74ls00/PinBasic/datasheet/ReadMe.md

LIN-601R cхема платы клавиатуры

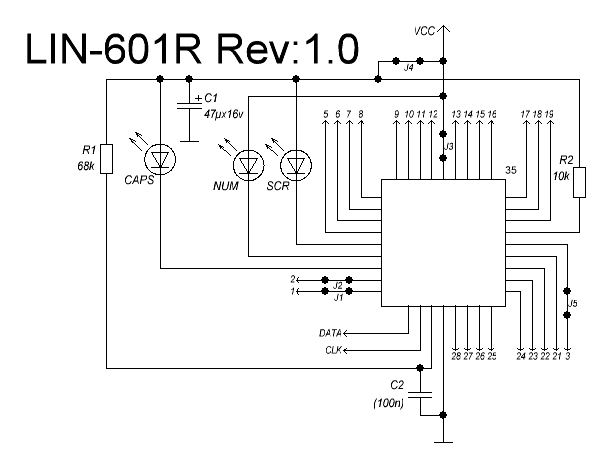
[picture p1: datasheet/LIN-601R.GIF]
