74ls00/PinBasic/todo.txt

112*61mm

порты слишком близком к кнопкам.

высота кнопок от 5-7мм.

кнопки шифт удобнее в центре.

аналоговые порты не могут быть испрользованы как выход ?
