74ls00/PinBasic/aduinobasic_sh.pdf

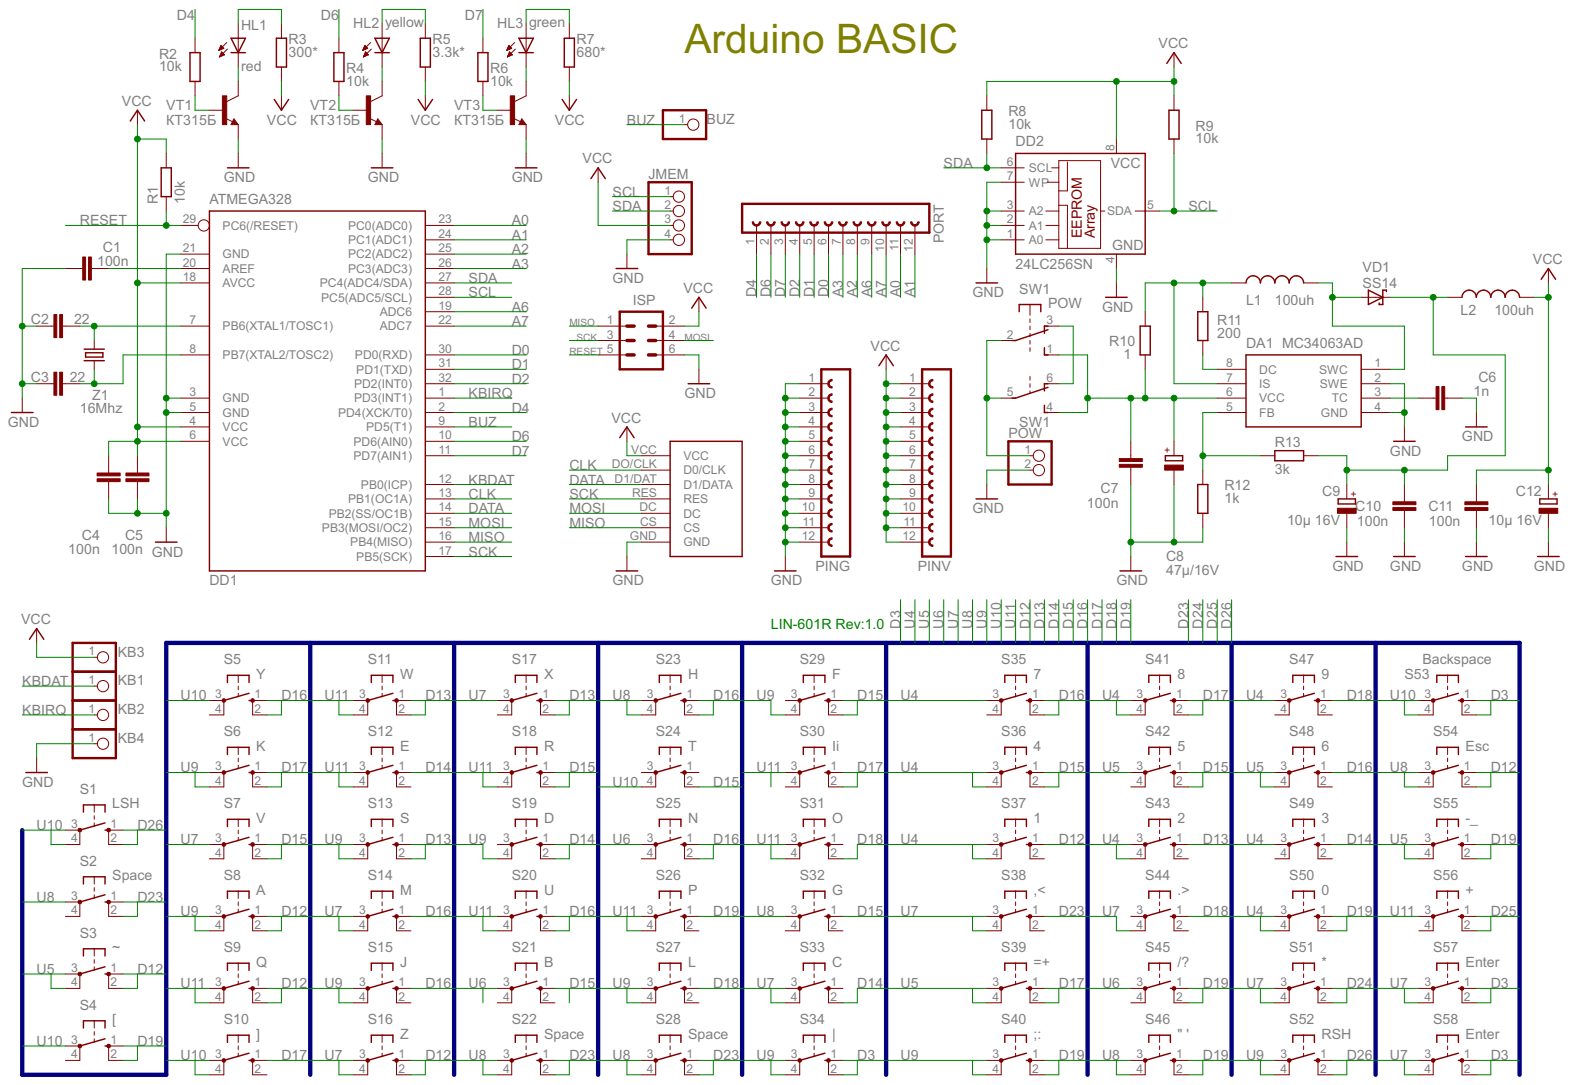
[picture p2: page 1]
