74ls00/PinBasic/(list of files, drawings)

Other design files:
datasheet/LIN-601R.spl7
keyboard.lay6
PinBASIC.lay6
TODO/ab.lay
