74ls00/PinBasic/aduinobasic.brd

## EAGLE design aduinobasic.brd (2017-09-14)

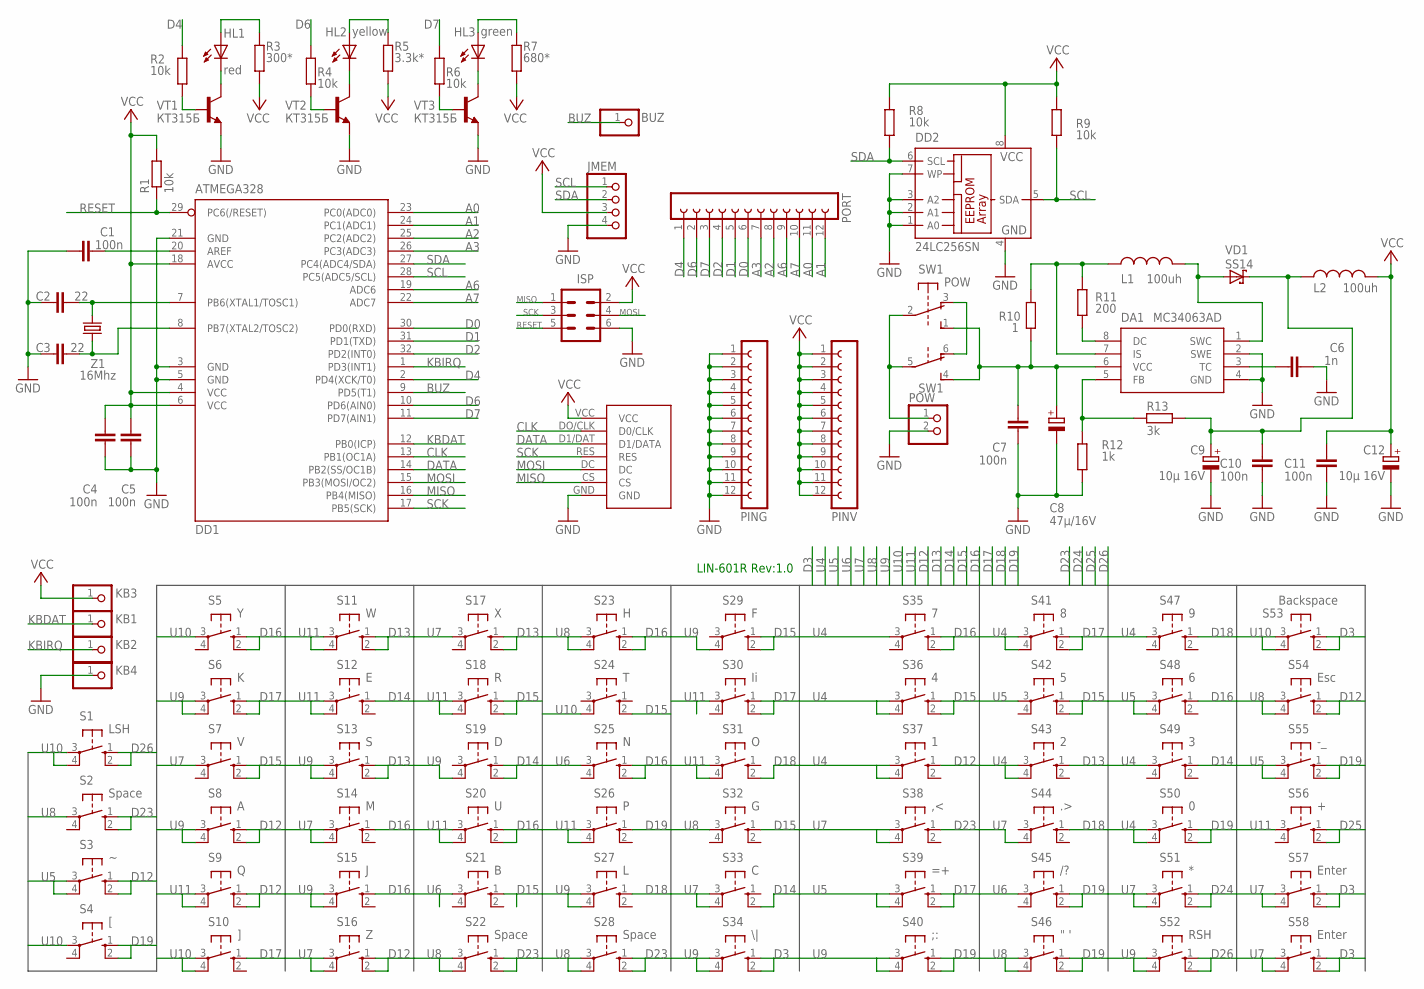
[picture p3: schematic aduinobasic.sch]

Parts:
BUZ: PINHD-1X1; 1X01
C1, C4, C5: 100n; C0805
C2, C3: 22; C025-025X050
C6: 1n; C025-025X050
C7, C10, C11: 100n; C1206
C8: 47µ/16V; RCL_E2-5
C9, C12: 10µ 16V; RCL_E2-5
DA1: MC34063AD; SOIC8
DD1: ATMEGA328; TQFP32-08
DD2: 24LC256SN; SO-08
DISPLAY: SSD1306; SSD1306_0.96
HL1: red; LED5MM
HL2: yellow; LED5MM
HL3: green; LED5MM
ISP: MA03-2
JMEM: PINHD-1X4; 1X04
KB1, KB2, KB3, KB4: PINHD-1X1; 1X01
L1: 100uh; 0207/10
L2: 100uh; 0204/5
PING: FE12-1; FE12
PINV: FE12-1; FE12
PORT: FE12-1; FE12
POW: PINHD-1X2; 1X02
R1, R2, R4, R6, R8, R9: 10k; R0805
R3: 300*; R1206W
R5: 3.3k*; R1206W
R7: 680*; R0805
R10: 1; M1206
R11: 200; M1206
R12: 1k; M0805
R13: 3k; M0805
S1: LSH; B3F-10XX
S2, S22, S28: Space; B3F-10XX
S3: B3F-10XX
S4: [; B3F-10XX
S5: Y; B3F-10XX
S6: K; B3F-10XX
S7: V; B3F-10XX
S8: A; B3F-10XX
S9: Q; B3F-10XX
S10: ]; B3F-10XX
S11: W; B3F-10XX
S12: E; B3F-10XX
S13: S; B3F-10XX
S14: M; B3F-10XX
S15: J; B3F-10XX
S16: Z; B3F-10XX
S17: X; B3F-10XX
S18: R; B3F-10XX
S19: D; B3F-10XX
S20: U; B3F-10XX
S21: B; B3F-10XX
S23: H; B3F-10XX
S24: T; B3F-10XX
S25: N; B3F-10XX
S26: P; B3F-10XX
S27: L; B3F-10XX
S29: F; B3F-10XX
S30: Ii; B3F-10XX
S31: O; B3F-10XX
S32: G; B3F-10XX
S33: C; B3F-10XX
S34: \|; B3F-10XX
S35: 7; B3F-10XX
S36: 4; B3F-10XX
S37: 1; B3F-10XX
S38: ,<; B3F-10XX
S39: =+; B3F-10XX
S40: ;:; B3F-10XX
S41: 8; B3F-10XX
S42: 5; B3F-10XX
S43: 2; B3F-10XX
S44: .>; B3F-10XX
S45: /?; B3F-10XX
S46: " '; B3F-10XX
S47: 9; B3F-10XX
S48: 6; B3F-10XX
S49: 3; B3F-10XX
S50: 0; B3F-10XX
S51: *; B3F-10XX
S52: RSH; B3F-10XX
S53: Backspace; B3F-10XX
S54: Esc; B3F-10XX
S55: -_; B3F-10XX
S56: +; B3F-10XX
S57, S58: Enter; B3F-10XX
SW1: POW; 9077-2
VD1: SS14; SMB
VT1, VT2, VT3: КТ315Б; TO92-ECB
Z1: 16Mhz; HC49/S

Connections:
A0: DD1.23 (PC0(ADC0)), PORT.11
A1: DD1.24 (PC1(ADC1)), PORT.12
A2: DD1.25 (PC2(ADC2)), PORT.8
A3: DD1.26 (PC3(ADC3)), PORT.7
A6: DD1.19 (ADC6), PORT.9
A7: DD1.22 (ADC7), PORT.10
AREF: C1.2, DD1.20 (AREF)
BUZ: BUZ.1, DD1.9 (PD5(T1))
CLK: DD1.13 (PB1(OC1A)), DISPLAY.DO/CLK (D0/CLK)
D0: DD1.30 (PD0(RXD)), PORT.6
D1: DD1.31 (PD1(TXD)), PORT.5
D2: DD1.32 (PD2(INT0)), PORT.4
D3: S34.1 (S), S34.2 (S1), S53.1 (S), S53.2 (S1), S57.1 (S), S57.2 (S1), S58.1 (S), S58.2 (S1)
D4: DD1.2 (PD4(XCK/T0)), PORT.1, R2.1
D6: DD1.10 (PD6(AIN0)), PORT.2, R4.1
D7: DD1.11 (PD7(AIN1)), PORT.3, R6.1
D12: S3.1 (S), S3.2 (S1), S8.1 (S), S8.2 (S1), S9.1 (S), S9.2 (S1), S16.1 (S), S16.2 (S1), S37.1 (S), S54.1 (S), S54.2 (S1)
D13: S11.1 (S), S11.2 (S1), S13.1 (S), S13.2 (S1), S17.1 (S), S17.2 (S1), S43.1 (S)
D14: S12.1 (S), S19.1 (S), S19.2 (S1), S33.2 (S1), S49.1 (S)
D15: S7.1 (S), S7.2 (S1), S18.1 (S), S18.2 (S1), S21.1 (S), S24.2 (S1), S29.1 (S), S29.2 (S1), S32.1 (S), S36.1 (S), S36.2 (S1), S42.1 (S), S42.2 (S1)
D16: S5.1 (S), S5.2 (S1), S14.1 (S), S15.1 (S), S20.1 (S), S20.2 (S1), S23.1 (S), S23.2 (S1), S25.1 (S), S25.2 (S1), S35.1 (S), S35.2 (S1), S48.1 (S)
D17: S6.1 (S), S6.2 (S1), S10.1 (S), S30.1 (S), S30.2 (S1), S39.1 (S), S39.2 (S1), S41.1 (S), S41.2 (S1)
D18: S27.1 (S), S31.2 (S1), S44.1 (S), S47.1 (S)
D19: S4.1 (S), S4.2 (S1), S26.1 (S), S40.1 (S), S40.2 (S1), S45.1 (S), S45.2 (S1), S46.1 (S), S46.2 (S1), S50.1 (S), S50.2 (S1), S55.1 (S), S55.2 (S1)
D23: S2.1 (S), S2.2 (S1), S22.1 (S), S22.2 (S1), S28.1 (S), S28.2 (S1), S38.1 (S)
D24: S51.1 (S), S51.2 (S1)
D25: S56.1 (S), S56.2 (S1)
D26: S1.1 (S), S1.2 (S1), S52.1 (S), S52.2 (S1)
DATA: DD1.14 (PB2(SS/OC1B)), DISPLAY.D1/DAT (D1/DATA)
GND: C1.1, C2.1, C3.1, C4.2, C5.2, C6.2, C7.2, C8.-, C9.-, C10.1, C11.1, C12.-, DA1.2 (SWE), DA1.4 (GND), DD1.3 (GND), DD1.5 (GND), DD1.21 (GND), DD2.1 (A0), DD2.2 (A1), DD2.3 (A2), DD2.4 (GND), DD2.7 (WP), DISPLAY.GND, ISP.6, JMEM.4, KB4.1, PING.1, PING.2, PING.3, PING.4, PING.5, PING.6, PING.7, PING.8, PING.9, PING.10, PING.11, PING.12, POW.2, R12.1, VT1.E, VT2.E, VT3.E
KBDAT: DD1.12 (PB0(ICP)), KB1.1
KBIRQ: DD1.1 (PD3(INT1)), KB2.1
MISO: DD1.16 (PB4(MISO)), DISPLAY.CS, ISP.1
MOSI: DD1.15 (PB3(MOSI/OC2)), DISPLAY.DC, ISP.4
unnamed: C2.2, DD1.7 (PB6(XTAL1/TOSC1)), Z1.2
unnamed: C3.2, DD1.8 (PB7(XTAL2/TOSC2)), Z1.1
unnamed: C7.1, C8.+, DA1.6 (VCC), R10.1, SW1.1 (S), SW1.4 (S)
unnamed: POW.1, SW1.2, SW1.5
unnamed: DA1.8 (DC), R11.1
unnamed: DA1.7 (IS), L1.1, R10.2, R11.2
unnamed: DA1.5 (FB), R12.2, R13.1
unnamed: DA1.1 (SWC), L1.2, VD1.A
unnamed: C6.1, DA1.3 (TC)
unnamed: SW1.3 (O), SW1.6 (O)
unnamed: HL1.K (C), VT1.C
unnamed: R2.2, VT1.B
unnamed: HL1.A, R3.1
unnamed: HL2.K (C), VT2.C
unnamed: R4.2, VT2.B
unnamed: HL2.A, R5.1
unnamed: HL3.K (C), VT3.C
unnamed: R6.2, VT3.B
unnamed: HL3.A, R7.1
unnamed: C9.+, C10.2, L2.1, R13.2, VD1.C
RESET: DD1.29 (PC6(/RESET)), ISP.5, R1.1
SCK: DD1.17 (PB5(SCK)), DISPLAY.RES, ISP.3
SCL: DD1.28 (PC5(ADC5/SCL)), DD2.5 (SDA), JMEM.1, R9.1
SDA: DD1.27 (PC4(ADC4/SDA)), DD2.6 (SCL), JMEM.2, R8.1
U4: S35.3, S36.3, S36.4 (P1), S37.3, S37.4 (P1), S41.3, S41.4 (P1), S43.3, S43.4 (P1), S47.3, S49.3, S50.3, S50.4 (P1)
U5: S3.3, S3.4 (P1), S39.3, S39.4 (P1), S42.3, S48.3, S48.4 (P1), S55.3, S55.4 (P1)
U6: S21.3, S25.3, S45.3
U7: S7.3, S14.3, S14.4 (P1), S16.3, S16.4 (P1), S17.3, S33.3, S33.4 (P1), S38.3, S38.4 (P1), S44.4 (P1), S51.3, S51.4 (P1), S57.3, S57.4 (P1), S58.3, S58.4 (P1)
U8: S2.3, S22.3, S22.4 (P1), S23.3, S23.4 (P1), S28.3, S28.4 (P1), S32.3, S46.3, S46.4 (P1), S54.3, S54.4 (P1)
U9: S6.3, S6.4 (P1), S8.3, S8.4 (P1), S13.3, S13.4 (P1), S15.3, S15.4 (P1), S19.4 (P1), S27.3, S27.4 (P1), S29.4 (P1), S34.3, S34.4 (P1), S40.3, S40.4 (P1), S52.3, S52.4 (P1)
U10: S1.3, S1.4 (P1), S4.3, S5.3, S10.3, S10.4 (P1), S24.4 (P1), S53.3, S53.4 (P1)
U11: S9.3, S9.4 (P1), S11.3, S11.4 (P1), S12.3, S12.4 (P1), S18.3, S18.4 (P1), S20.3, S20.4 (P1), S26.3, S26.4 (P1), S30.3, S31.3, S31.4 (P1), S56.3
VCC: C4.1, C5.1, C11.2, C12.+, DD1.4 (VCC), DD1.6 (VCC), DD1.18 (AVCC), DD2.8 (VCC), DISPLAY.VCC, ISP.2, JMEM.3, KB3.1, L2.2, PINV.1, PINV.2, PINV.3, PINV.4, PINV.5, PINV.6, PINV.7, PINV.8, PINV.9, PINV.10, PINV.11, PINV.12, R1.2, R3.2, R5.2, R7.2, R8.2, R9.2

Notes on the sheet:
LIN-601R Rev:1.0

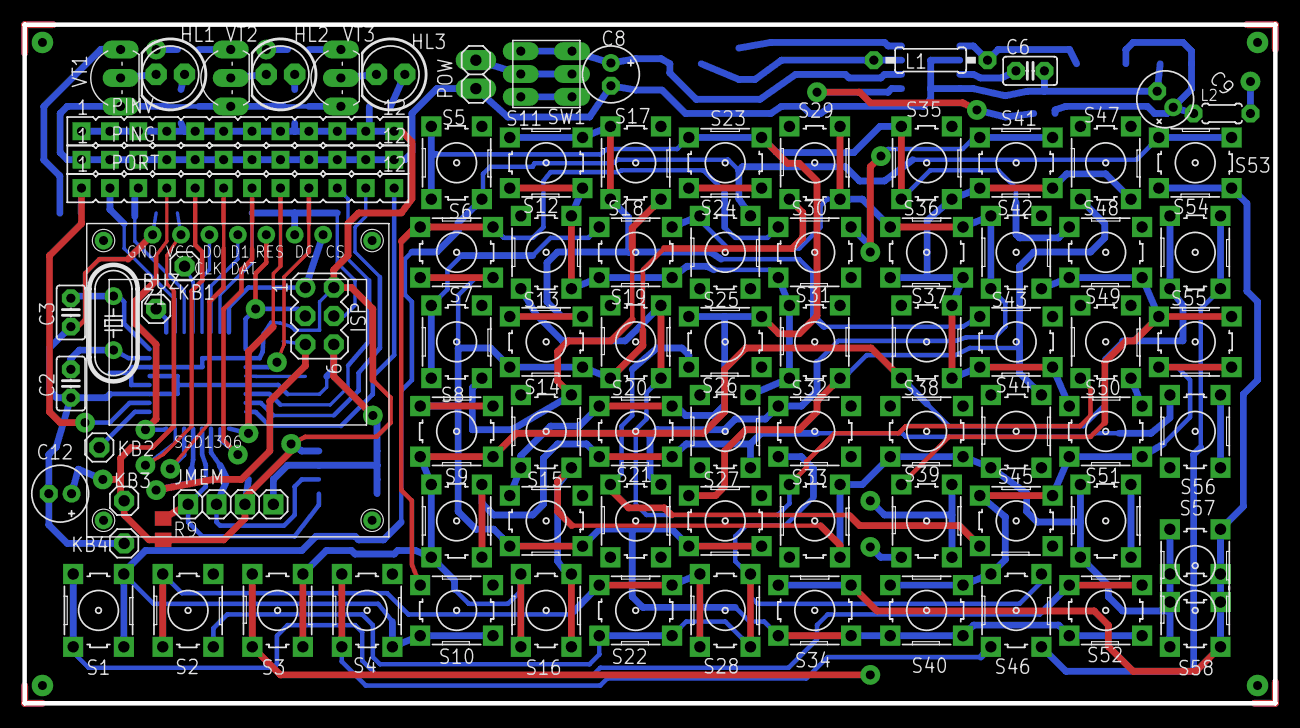
[picture p4: board aduinobasic.brd from above]

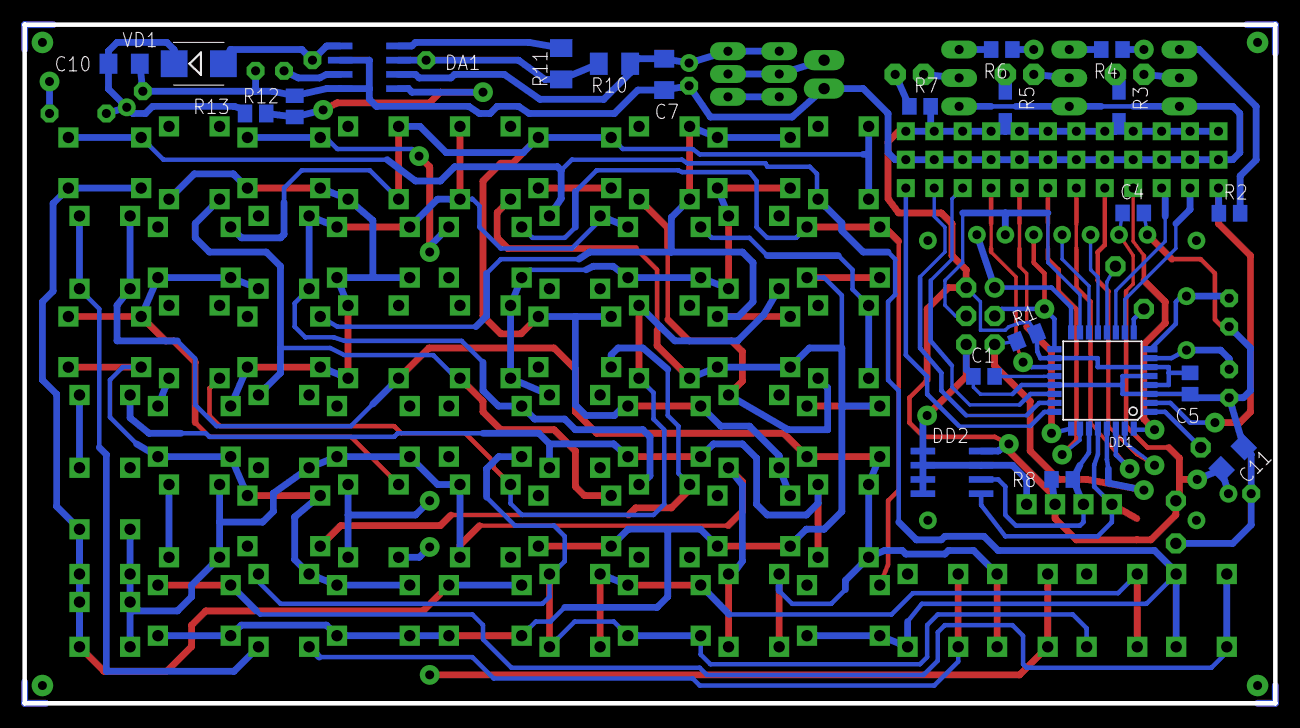
[picture p5: board aduinobasic.brd from below]

Board: 2 copper layers, 111.8 x 60.6 mm, 109 parts (22 on the bottom side), 67 nets.
